panoseti/shuttercontrol/docs/rev2-j/ckt_rev2j.jpeg

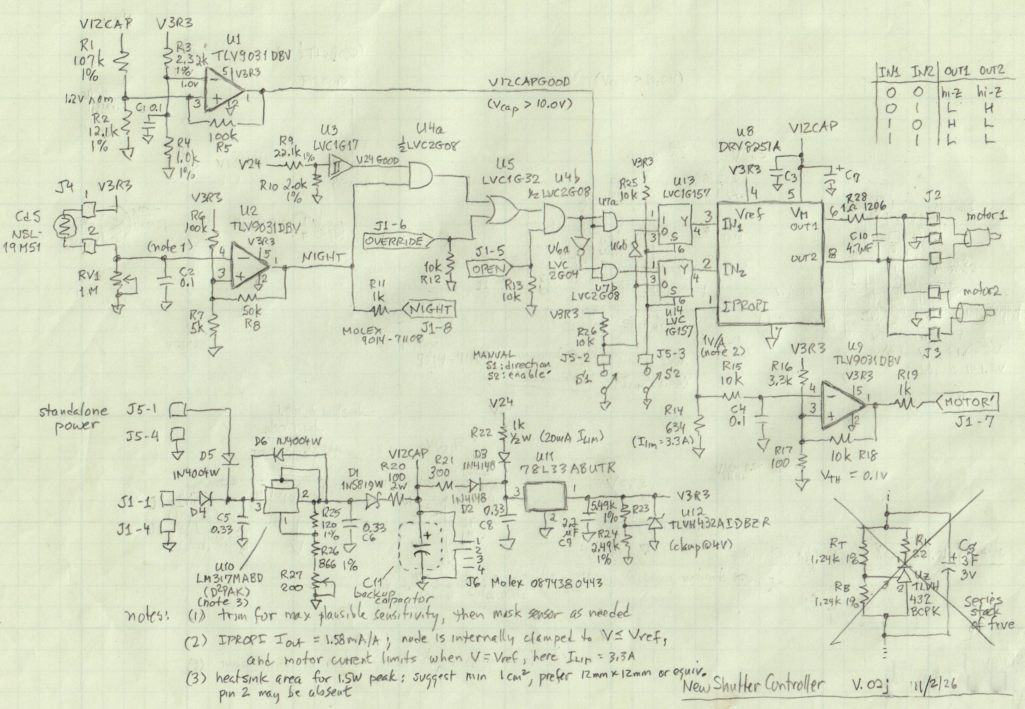
docs/rev2-j/ckt_rev2j.jpeg
