panoseti/shuttercontrol/docs/jlcpcb_capabilities.md

# 嘉立创（JLCPCB）工艺能力与本板设计规则

来源：<https://jlcpcb.com/capabilities/Capabilities>（Rigid PCB，标准工艺），2026-11-02 查阅。
本板：4 层，1.6 mm，外层 1 oz、内层 0.5 oz（嘉立创多层板默认），无铅喷锡，绿色阻焊。

## 叠层

| 层 | 用途 |
|---|---|
| F.Cu | 器件、信号 |
| In1.Cu | GND 整层铺铜（区域名 GND_PLANE） |
| In2.Cu | V3R3 整层铺铜（区域名 V3R3_PLANE） |
| B.Cu | 器件、信号 |

嘉立创 4 层 1.6 mm 标准叠层为 JLC04161H-7628：7628 半固化片约 0.21 mm，芯板约 1.065 mm。KiCad 中的介质厚度目前按平均值 0.48 mm 填写。本板不做阻抗控制，DRC 不受影响，下单时选择标准叠层即可。

## 工艺能力与设定值

| 项目 | 嘉立创能力（多层板，1 oz） | 本板设定 | 写在哪里 |
|---|---|---|---|
| 最小线宽 / 线距 | 0.09 / 0.09 mm（1、2 层板为 0.10 / 0.10 mm） | 最小 0.1 / 0.1 mm；默认网络类线宽 0.2 mm、间距 0.2 mm | `.kicad_pro` |
| 钻孔直径 | 0.15–6.3 mm | 0.15–6.3 mm | `.kicad_dru` |
| 过孔孔径 / 外径 | 最小 0.15 / 0.25 mm；孔径 < 0.2 mm 或外径 < 0.45 mm 加价 | 最小 0.2 / 0.45 mm；默认 0.3 / 0.6 mm | `.kicad_pro`、`.kicad_dru` |
| 孔环 | 插件孔最小 0.15 mm，推荐 0.20 mm；过孔只要求外径 ≥ 孔径 + 0.1 mm | 插件孔 0.15 mm（0.45 / 0.2 mm 过孔的孔环为 0.125 mm） | `.kicad_dru` |
| 孔到孔 | 过孔 0.2 mm；焊盘孔 0.45 mm | 0.2 mm；焊盘之间 0.45 mm | `.kicad_pro`、`.kicad_dru` |
| 孔壁到铜 | 过孔 0.2 mm；插件孔 0.28 mm（推荐 0.35 mm）；非金属化孔 0.2 mm | 0.2 mm；插件孔 0.28 mm | `.kicad_dru` |
| 内层孔壁到铜 | 过孔 0.2 mm；插件焊盘孔 0.3 mm | 插件孔 0.3 mm | `.kicad_dru` |
| 焊盘到导线 | 0.1 mm | 网络类间距 0.2 mm | `.kicad_pro` |
| 不同网络 SMD 焊盘间距 | 0.15 mm | 0.15 mm | `.kicad_dru` |
| 铜到板边（铣边） | 0.2 mm（V 割 0.4 mm） | 0.3 mm | `.kicad_pro`、`.kicad_dru` |
| 阻焊 | 开窗 1:1；阻焊桥最小 0.10 mm（绿色） | 未改，沿用 KiCad 设置 | — |
| 丝印 | 线宽 ≥ 0.15 mm；字高 ≥ 1.0 mm；宽高比 1:6；丝印到焊盘 ≥ 0.15 mm | 位号统一 1.0 mm 字高、0.15 mm 线宽；丝印间距 0.15 mm | `.kicad_dru` |
| 非金属化孔 | 最小 0.5 mm | 安装孔 2.5 mm | — |

其他参考数据：

- 孔径公差 +0.13 / −0.08 mm。
- 外形尺寸公差 ±0.2 mm（普通精度）。
- 板厚可选 0.4 / 0.6 / 0.8 / 1.0 / 1.2 / 1.6 / 2.0 mm。
- 介电常数：7628 半固化片 4.4，3313 为 4.1，2116 为 4.16。
- 内层铜厚默认 0.5 oz，可选 1 oz、2 oz。

## 文件

- `shuttercontrol.kicad_dru`：自定义规则，每条注明来源。
- `shuttercontrol.kicad_pro`：板级最小值、默认网络类，以及常用线宽（0.2 / 0.25 / 0.4 / 0.6 / 1.0 mm）和过孔尺寸（0.6/0.3、0.8/0.4 mm）。
- `docs/shuttercontrol_board_spec.json`：板子外形、安装孔和 4 层叠层。
