panoseti/shuttercontrol/docs/c11_footprint.png

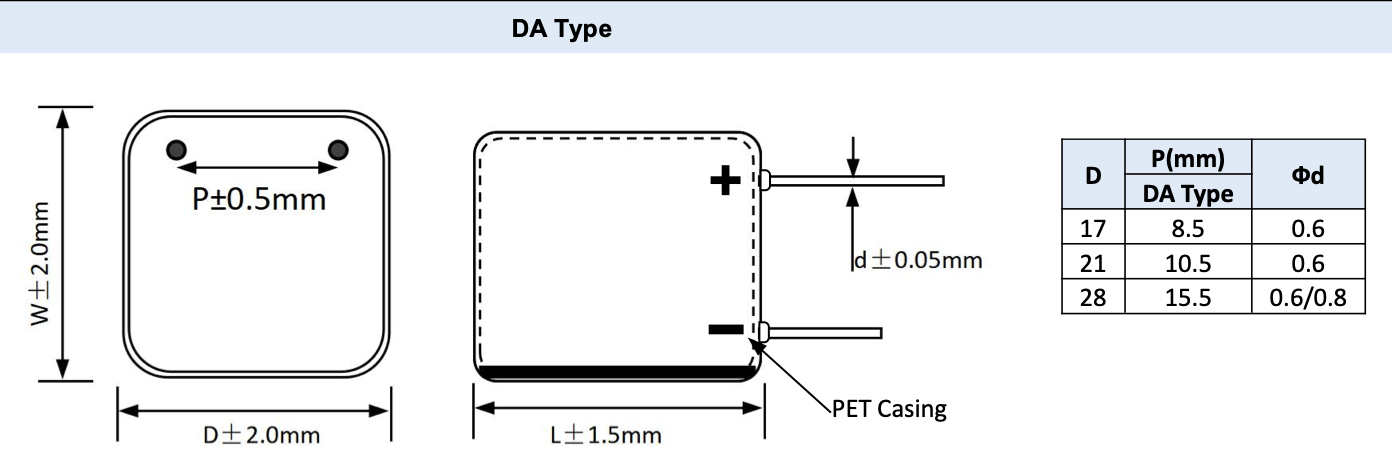
docs/c11_footprint.png
