panoseti/shuttercontrol/docs/rev2-h/ckt_rev2h_p2of2.jpg

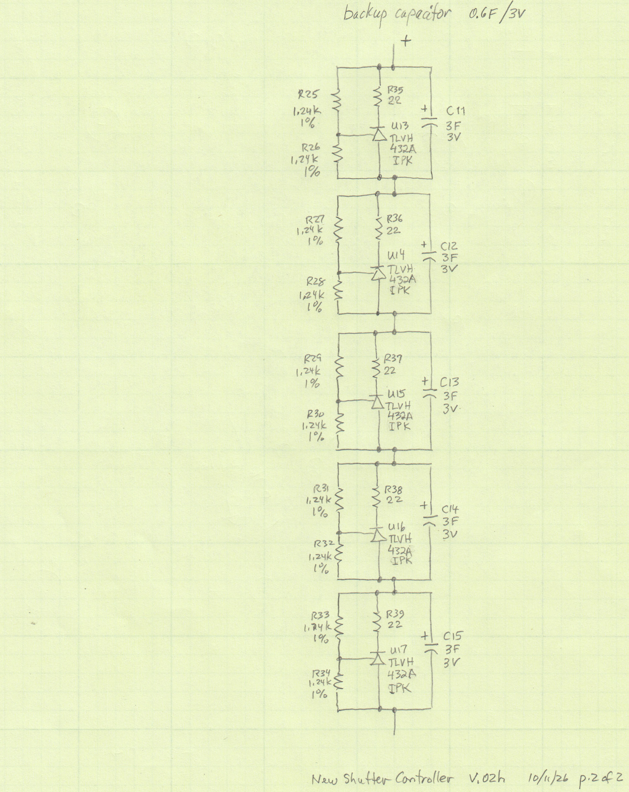
docs/rev2-h/ckt_rev2h_p2of2.jpg
