panoseti/shuttercontrol/outputs/shuttercontrol_3d_bottom.png

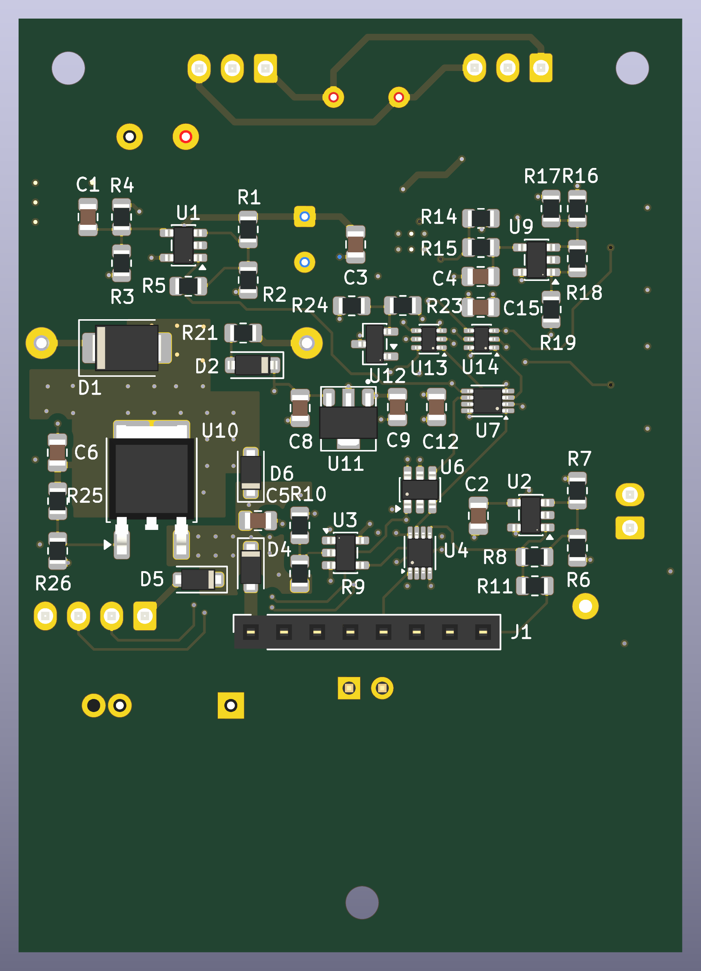
outputs/shuttercontrol_3d_bottom.png
