panoseti/shuttercontrol/outputs/shuttercontrol_3d_iso.png

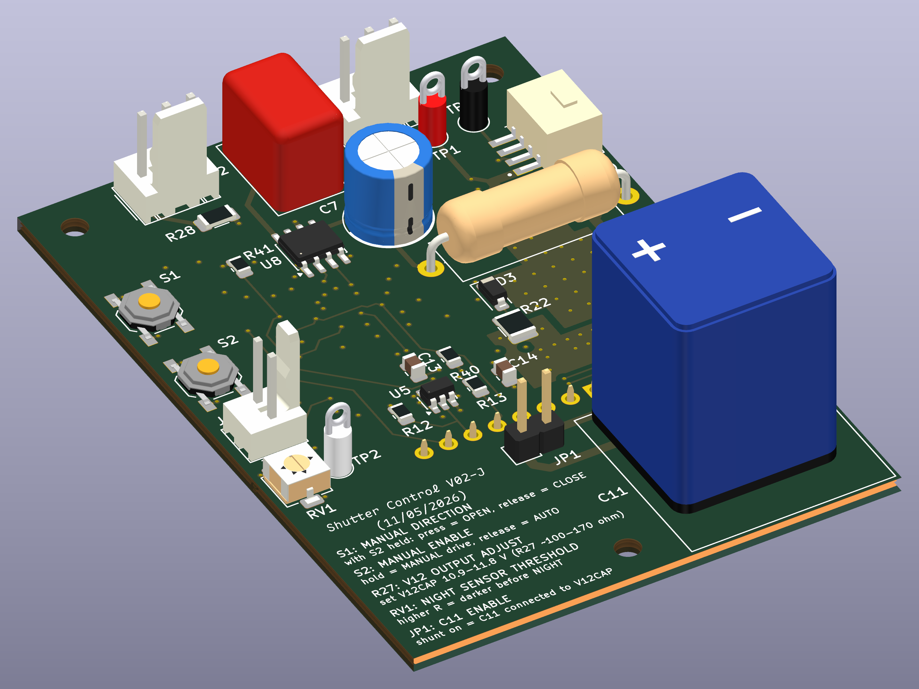
outputs/shuttercontrol_3d_iso.png
