panoseti/shuttercontrol/outputs/shuttercontrol_3d_side.png

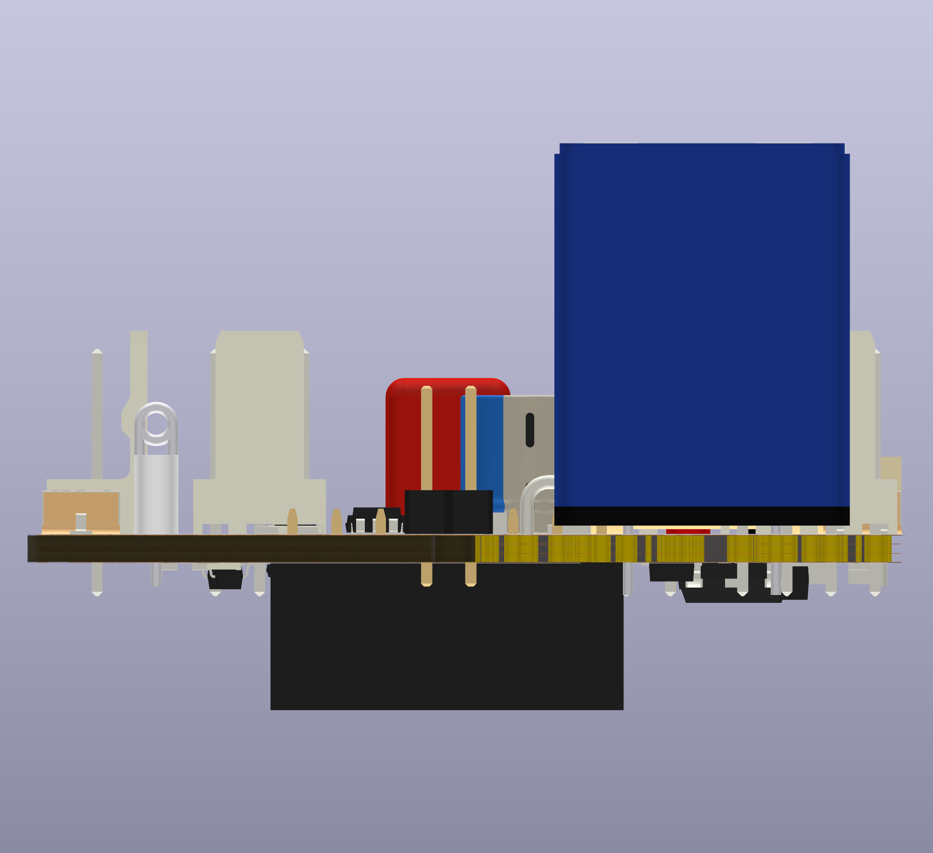
outputs/shuttercontrol_3d_side.png
