panoseti/shuttercontrol/outputs/shuttercontrol_3d_top.png

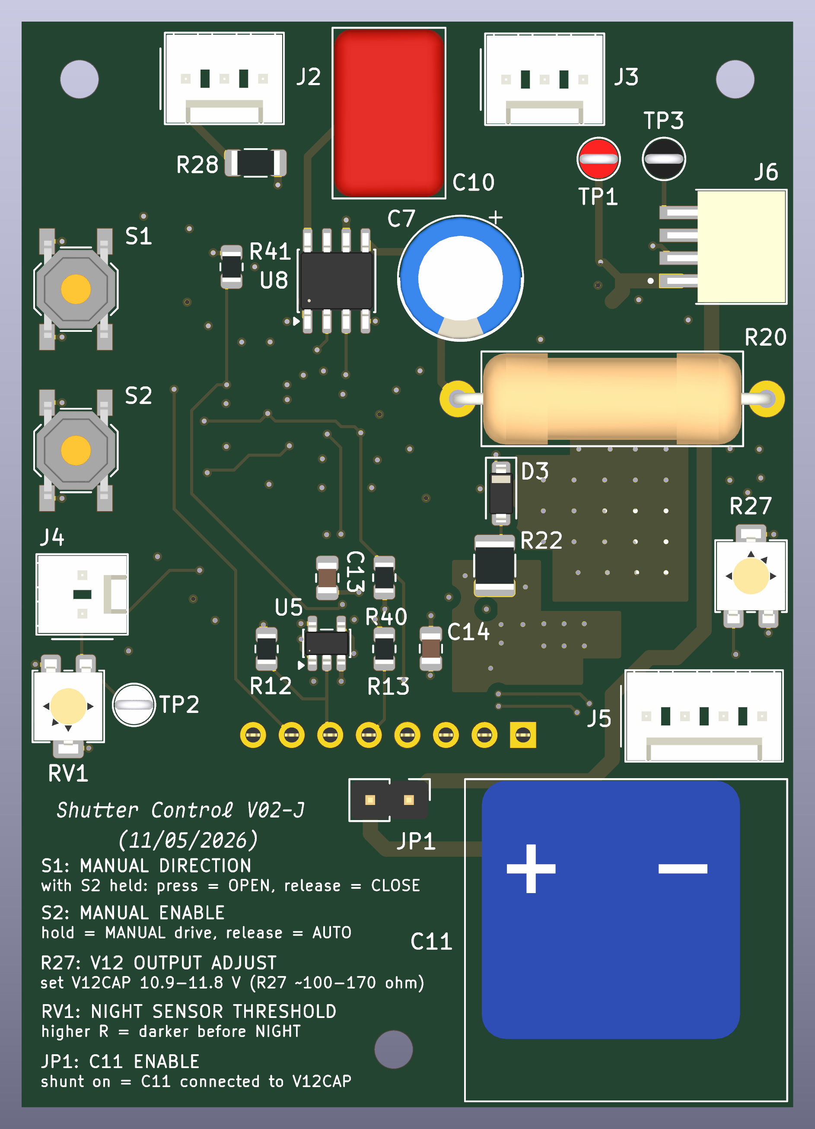
outputs/shuttercontrol_3d_top.png
