panoseti/shuttercontrol/docs/rev2-j/BOM_shutter-controller_2026-11-02.xlsx

Refdes | Description | Value | Manufacturer | Mfg P/N | DigiKey P/N | JLCPCB P/N (*=pre-order) |  | Notes & Substitutions
rev 1.1, 2026-11-02
C1-C4 | capacitor, MLCC, 0805 | 0.1 uF |  |  |  | C49678
C5, C6, C8 | capacitor, MLCC, 0805 | 0.33 uF |  |  |  | C13967
C7 | capacitor, radial, electrolytic, thru-hole | 47 uF, 50V or 63V | Nichicon | UBT1J470MPD8TD | 493-UBT1J470MPD8TDCT-ND |  | DNP
C9 | capacitor, MLCC, 0805 | 2.2 uF |  |  |  | C377773
C10 | capacitor, film, through-hole | 4.7 uF | TDK | B32529D5475M289 | 495-B32529D5475M289CT-ND |  | DNP
C11 | ultracap, through-hole | 0.8F, 12V | Oda | CPM-12R0L804R-TW | 4688-CPM-12R0L804R-TW |  | DNP | optional on-board ultracap
C11 off-board | ultracap, off-board | 1.66F, 16.2V | Tecate | PBLS-1.66/16.2 | 2085-SCAP,PBLS-1.66/16.2-ND |  | N/A | for altenative off-board ultracap
D1 | rectifier, Schottky | 1 A 40V |  | 1N5819W |  | C8165 |  | SMD equiv to 1N5819
D2, D3 | diode | 100 mA 75V |  | 1N4148W |  | C117823 |  | SMD equiv to 1N4148
D4, D5, D6 | rectifier, silicon | 1A 400V |  | 1N4004W |  | C18199087 |  | SMD equiv to 1N4004
J1 | MOBO connector, 8-pin SIP, female |  | Molex | 9014-71108 |  | C6032581 |  | no stock at JLCPCB, we could do as a secondary op with other thru-hole parts
J2, J3 | motor connector, 3-pin | TBD
J4 | photocell connector, 2-pin | TBD
J5 | aux power connector, manual op'n | TBD
J6 | connector to external ultracap | 4-pin through-hole | Molex | 874380443 |  | C564208
R* | resistor, SMD, 0805 | closest E24 value, 5% |  |  |  |  |  | all resistors not specifically listed are 0805 SMD closest E24 value to schematic
R1 | resistor, SMD, 0805 | 107k, 1% |  |  |  | C276295
R2 | resistor, SMD, 0805 | 12.1k, 1%
R3 | resistor, SMD, 0805 | 2.32k, 1%
R4 | resistor, SMD, 0805 | 1.0k, 1%
R9 | resistor, SMD, 0805 | 22.1k, 1%
R10 | resistor, SMD, 0805 | 2.0k, 1%
R14 | resistor, SMD, 0805 | 634 ohms, 1%
R20 | resistor | 100 ohms, 10%, 2W
R22 | resistor | 1k, 5%, 0.5W
R23 | resistor, SMD, 0805 | 5.49k, 1%
R24 | resistor, SMD, 0805 | 2.49k, 1%
R25 | resistor, SMD, 0805 | 120 ohms, 1%
R26 | resistor, SMD, 0805 | 866 ohms, 1%
R27 | trimmer | 200 ohms | Bourns | 3314G-1-201E |  | C52238 |  | SMD 1/4" 1-turn top-adjust
R28 | resistor, SMD, 1206 | 1 ohm |  |  |  | C17928
RV1 | trimmer | 1Mohm | Bourns | 3314G-1-105E |  | C780218 |  | SMD 1/4" 1-turn top-adjust
S1,S2 | pushbutton, SMD, momentary contact
U1, U2, U9 | op-amp | TLV9031DBV | TI | TLV9031DBV |  | C29777121
U3 | logic buffer, Schmitt | 74LVC1G17DBV | TI | 74LVC1G17DBV |  | C7836
U4, U7 | AND gate, dual | 74LVC2G08DCT | TI | 74LVC2G08DCT |  | C456135
U5 | OR gate | 74LVC1G32DBV | TI | 74LVC1G32DBV |  | C10096
U6 | inverter, dual | 74LVC2G04DBV | TI | 74LVC2G04DBV |  | C10428
U8 | H-bridge motor driver | DRV8251ADDAR | TI | DRV8251ADDAR |  | C5218844
U10 | adjustable linear regulator | LM317MABD | TI | LM317MABD |  | C427699
U11 | 3.3V linear regulator | L78L33ABUTR | STM | L78L33ABUTR |  | C81362
U12 | 1.2vV shunt regulator | TLVH432AIDBZR | TI | TLVH432AIDBZR |  | C2157628
- | DIP-10 carrier for U16 and U20 | pitch 100 mils, width 600 mils | Artekit Labs | DA-SOT223-6-P127 | 4695-DA-SOT223-6-P127 | 3.16
