panoseti/shuttercontrol/outputs/shuttercontrol_schematic_pcb.pdf

# 51k GND

# Backup Capacitor (C11, J6)

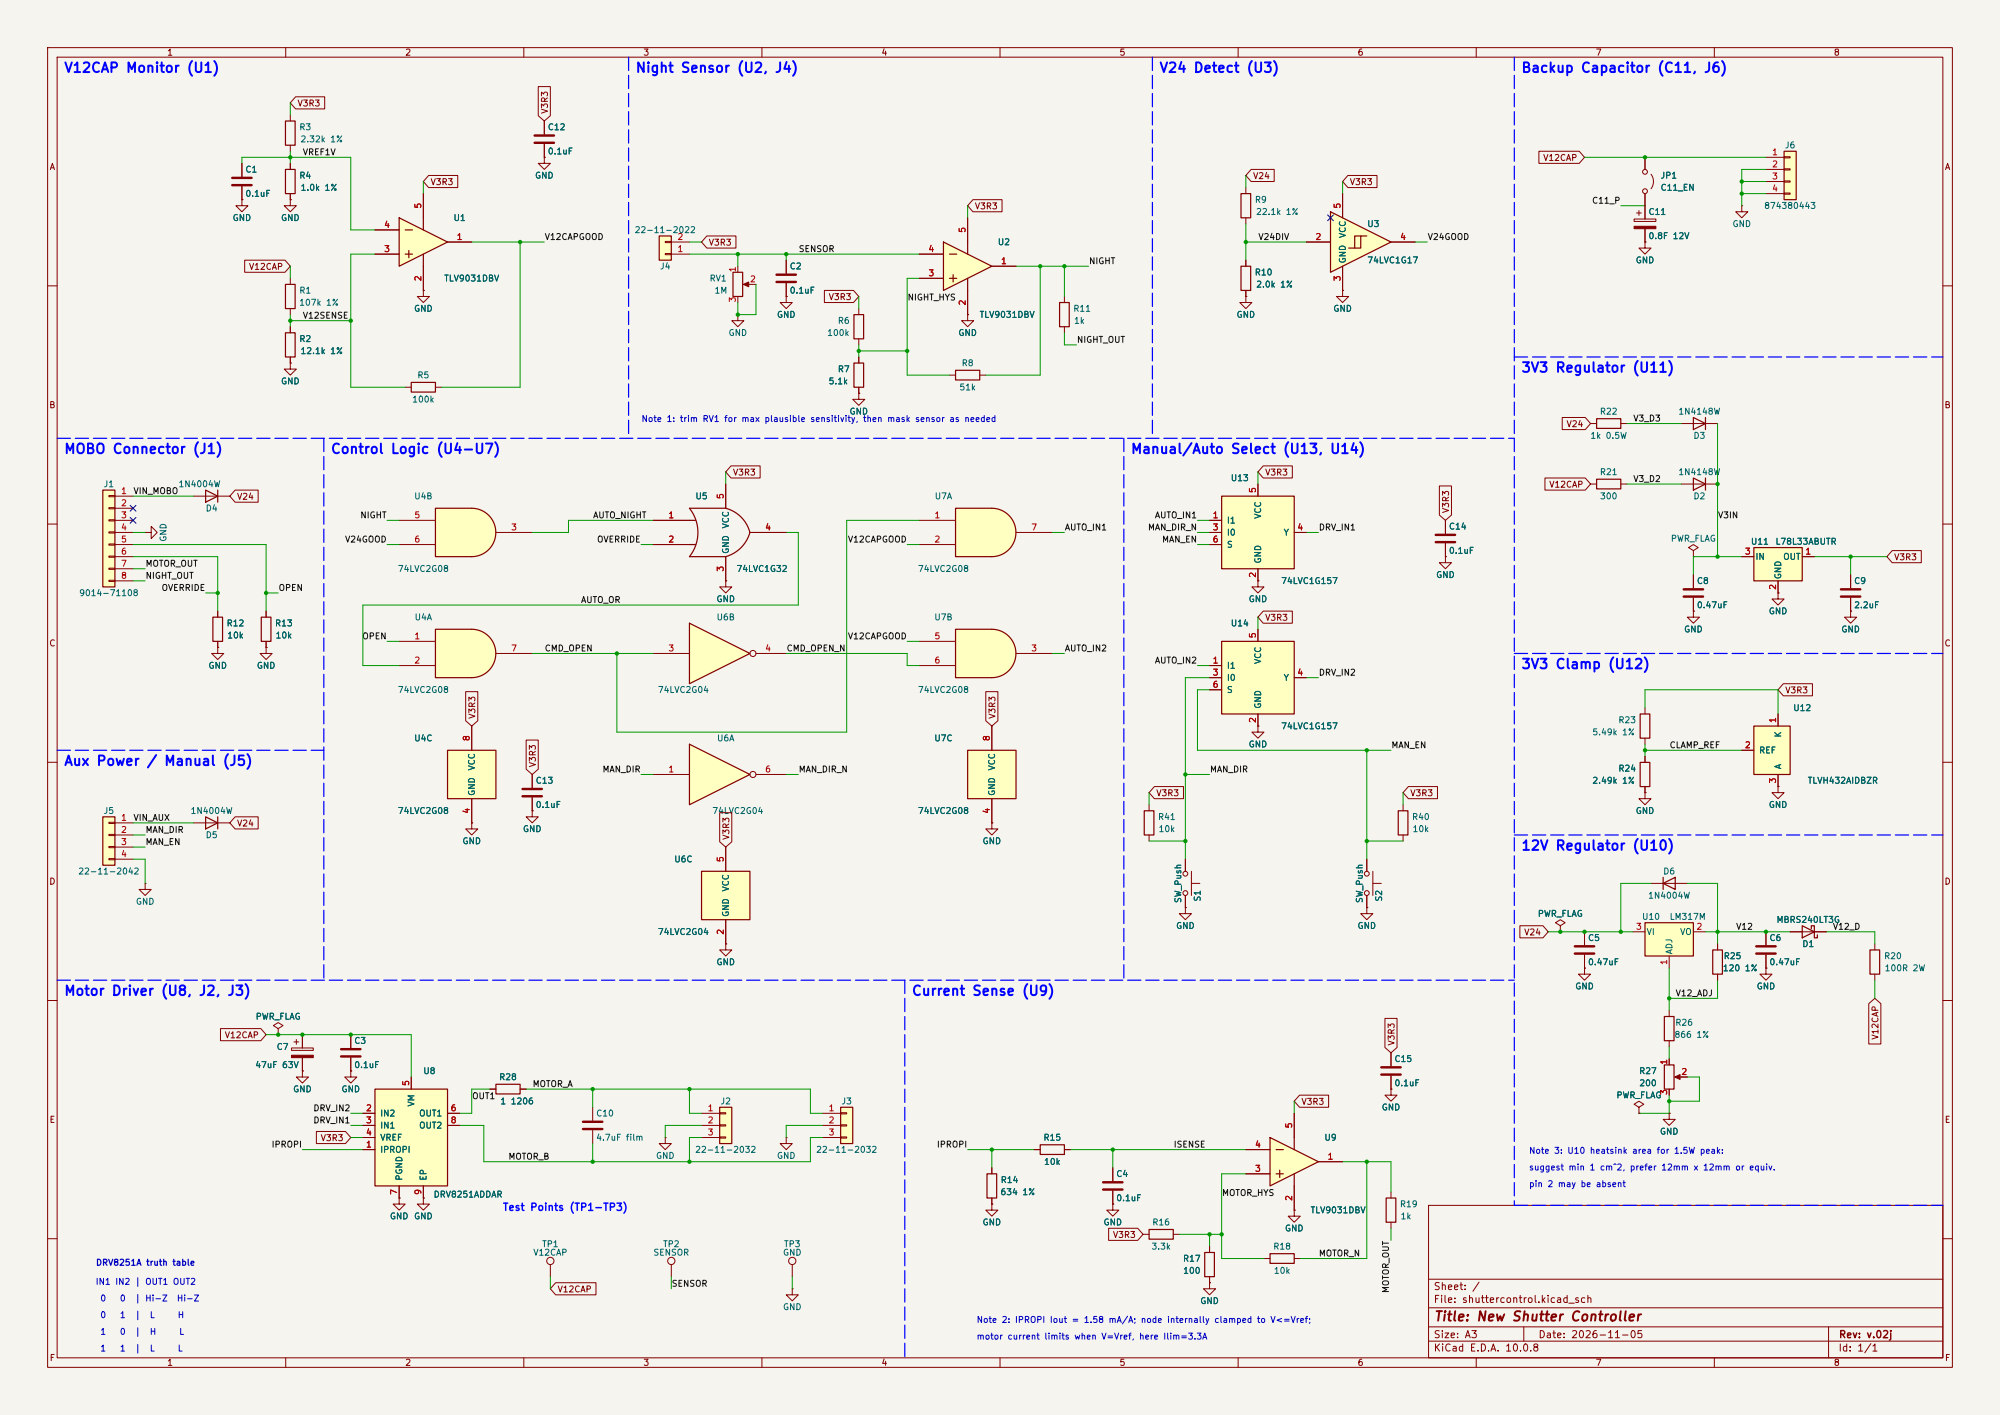
[picture p9: page 1]

Note 1: trim RV1 for max plausible sensitivity, then mask sensor as needed

pin 2 may be absent MOBO Connector (J1)

DRV8251A truth table Motor Driver (U8, J2, J3)

suggest min 1 cm^2, prefer 12mm x 12mm or equiv. Note 3: U10 heatsink area for 1.5W peak:

Sheet: /
File: shuttercontrol.kicad_sch
Title: New Shutter Controller
KiCad E.D.A. 10.0.8

TP1

TP3

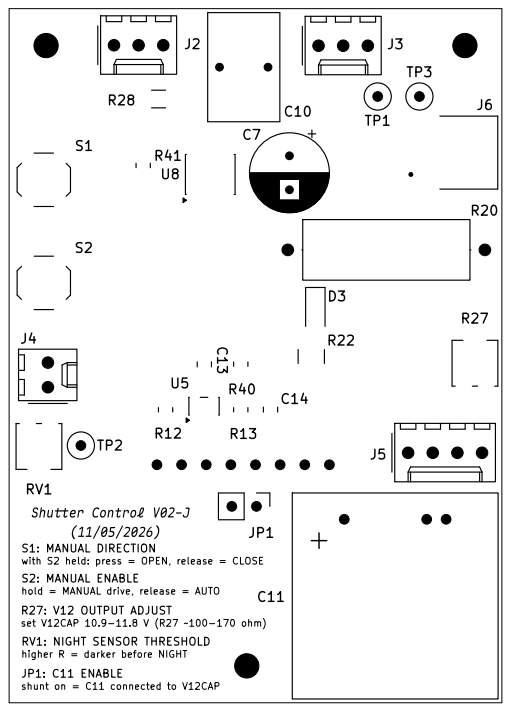
[picture p10: page 2]

S1: MANUAL DIRECTION
with S2 held: press = OPEN, release = CLOSE
S2: MANUAL ENABLE
hold = MANUAL drive, release = AUTO
R27: V12 OUTPUT ADJUST
set V12CAP 10.9-11.8 V (R27 ~100-170 ohm)
RV1: NIGHT SENSOR THRESHOLD
higher R = darker before NIGHT
JP1: C11 ENABLE
shunt on = C11 connected to V12CAP

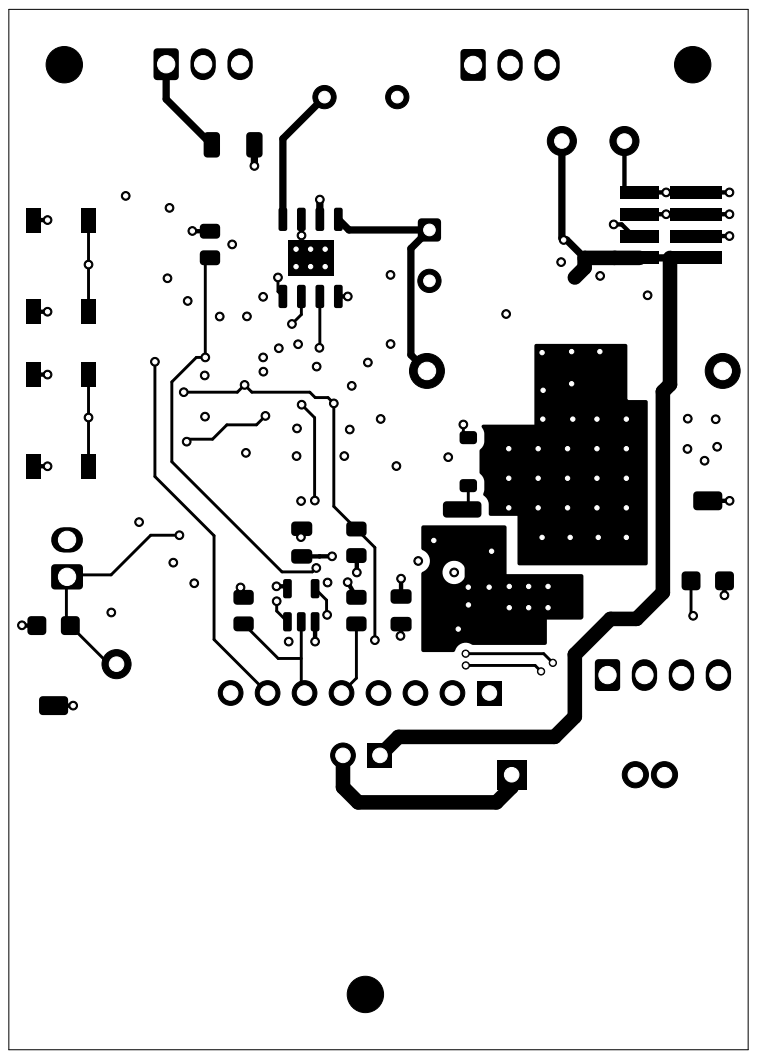
[picture p11: page 3]

H2

# MountingHole_2.5mm

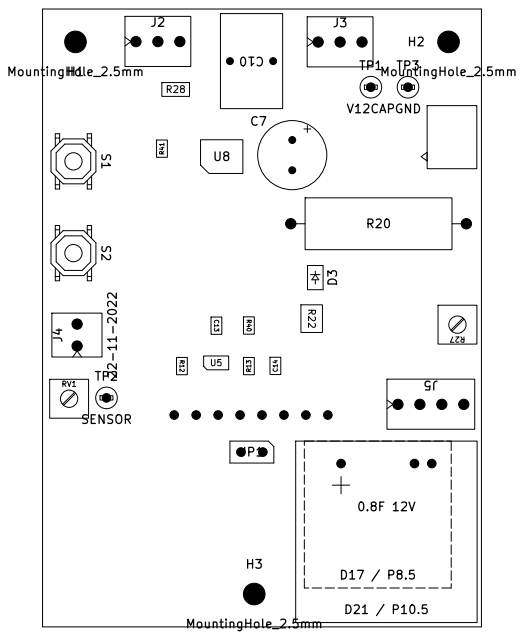
[picture p12: page 4]

R17
R4

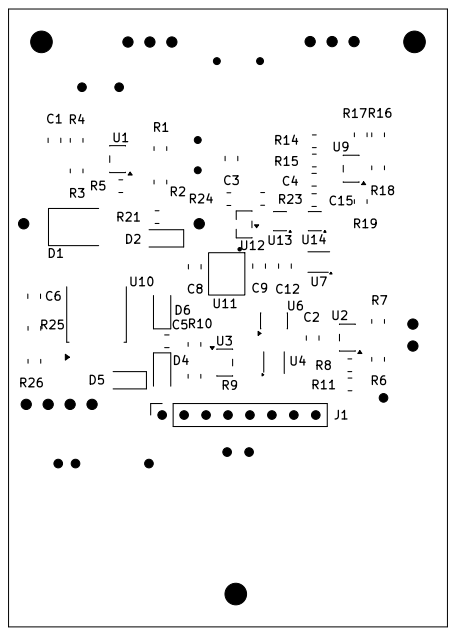
[picture p13: page 5]

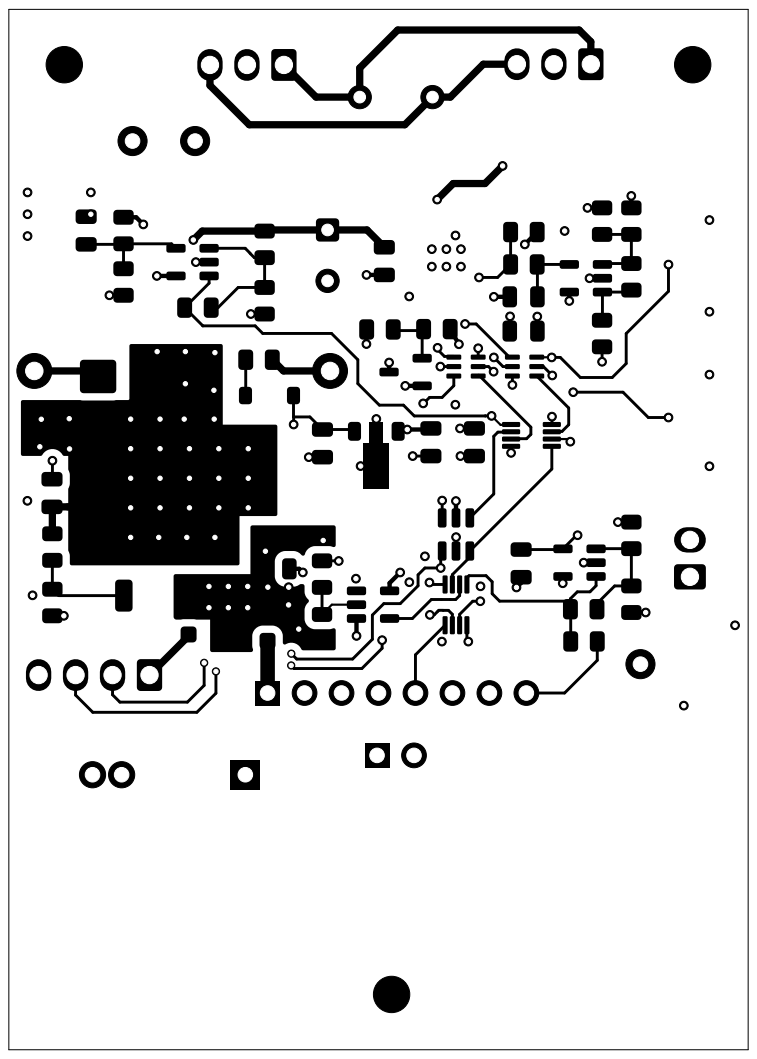
[picture p14: page 6]

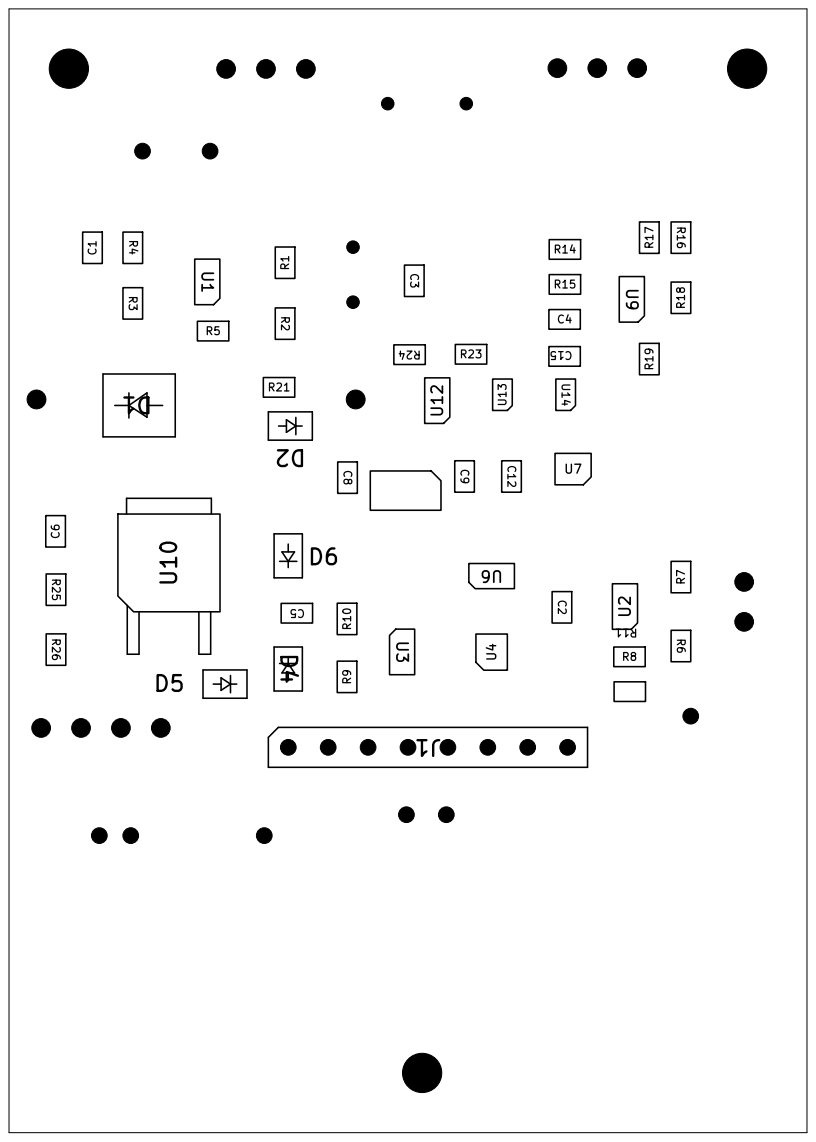
[picture p15: page 7]
