panoseti/shuttercontrol/shuttercontrol.kicad_pcb

## KiCad design shuttercontrol.kicad_pcb (2026-11-09)

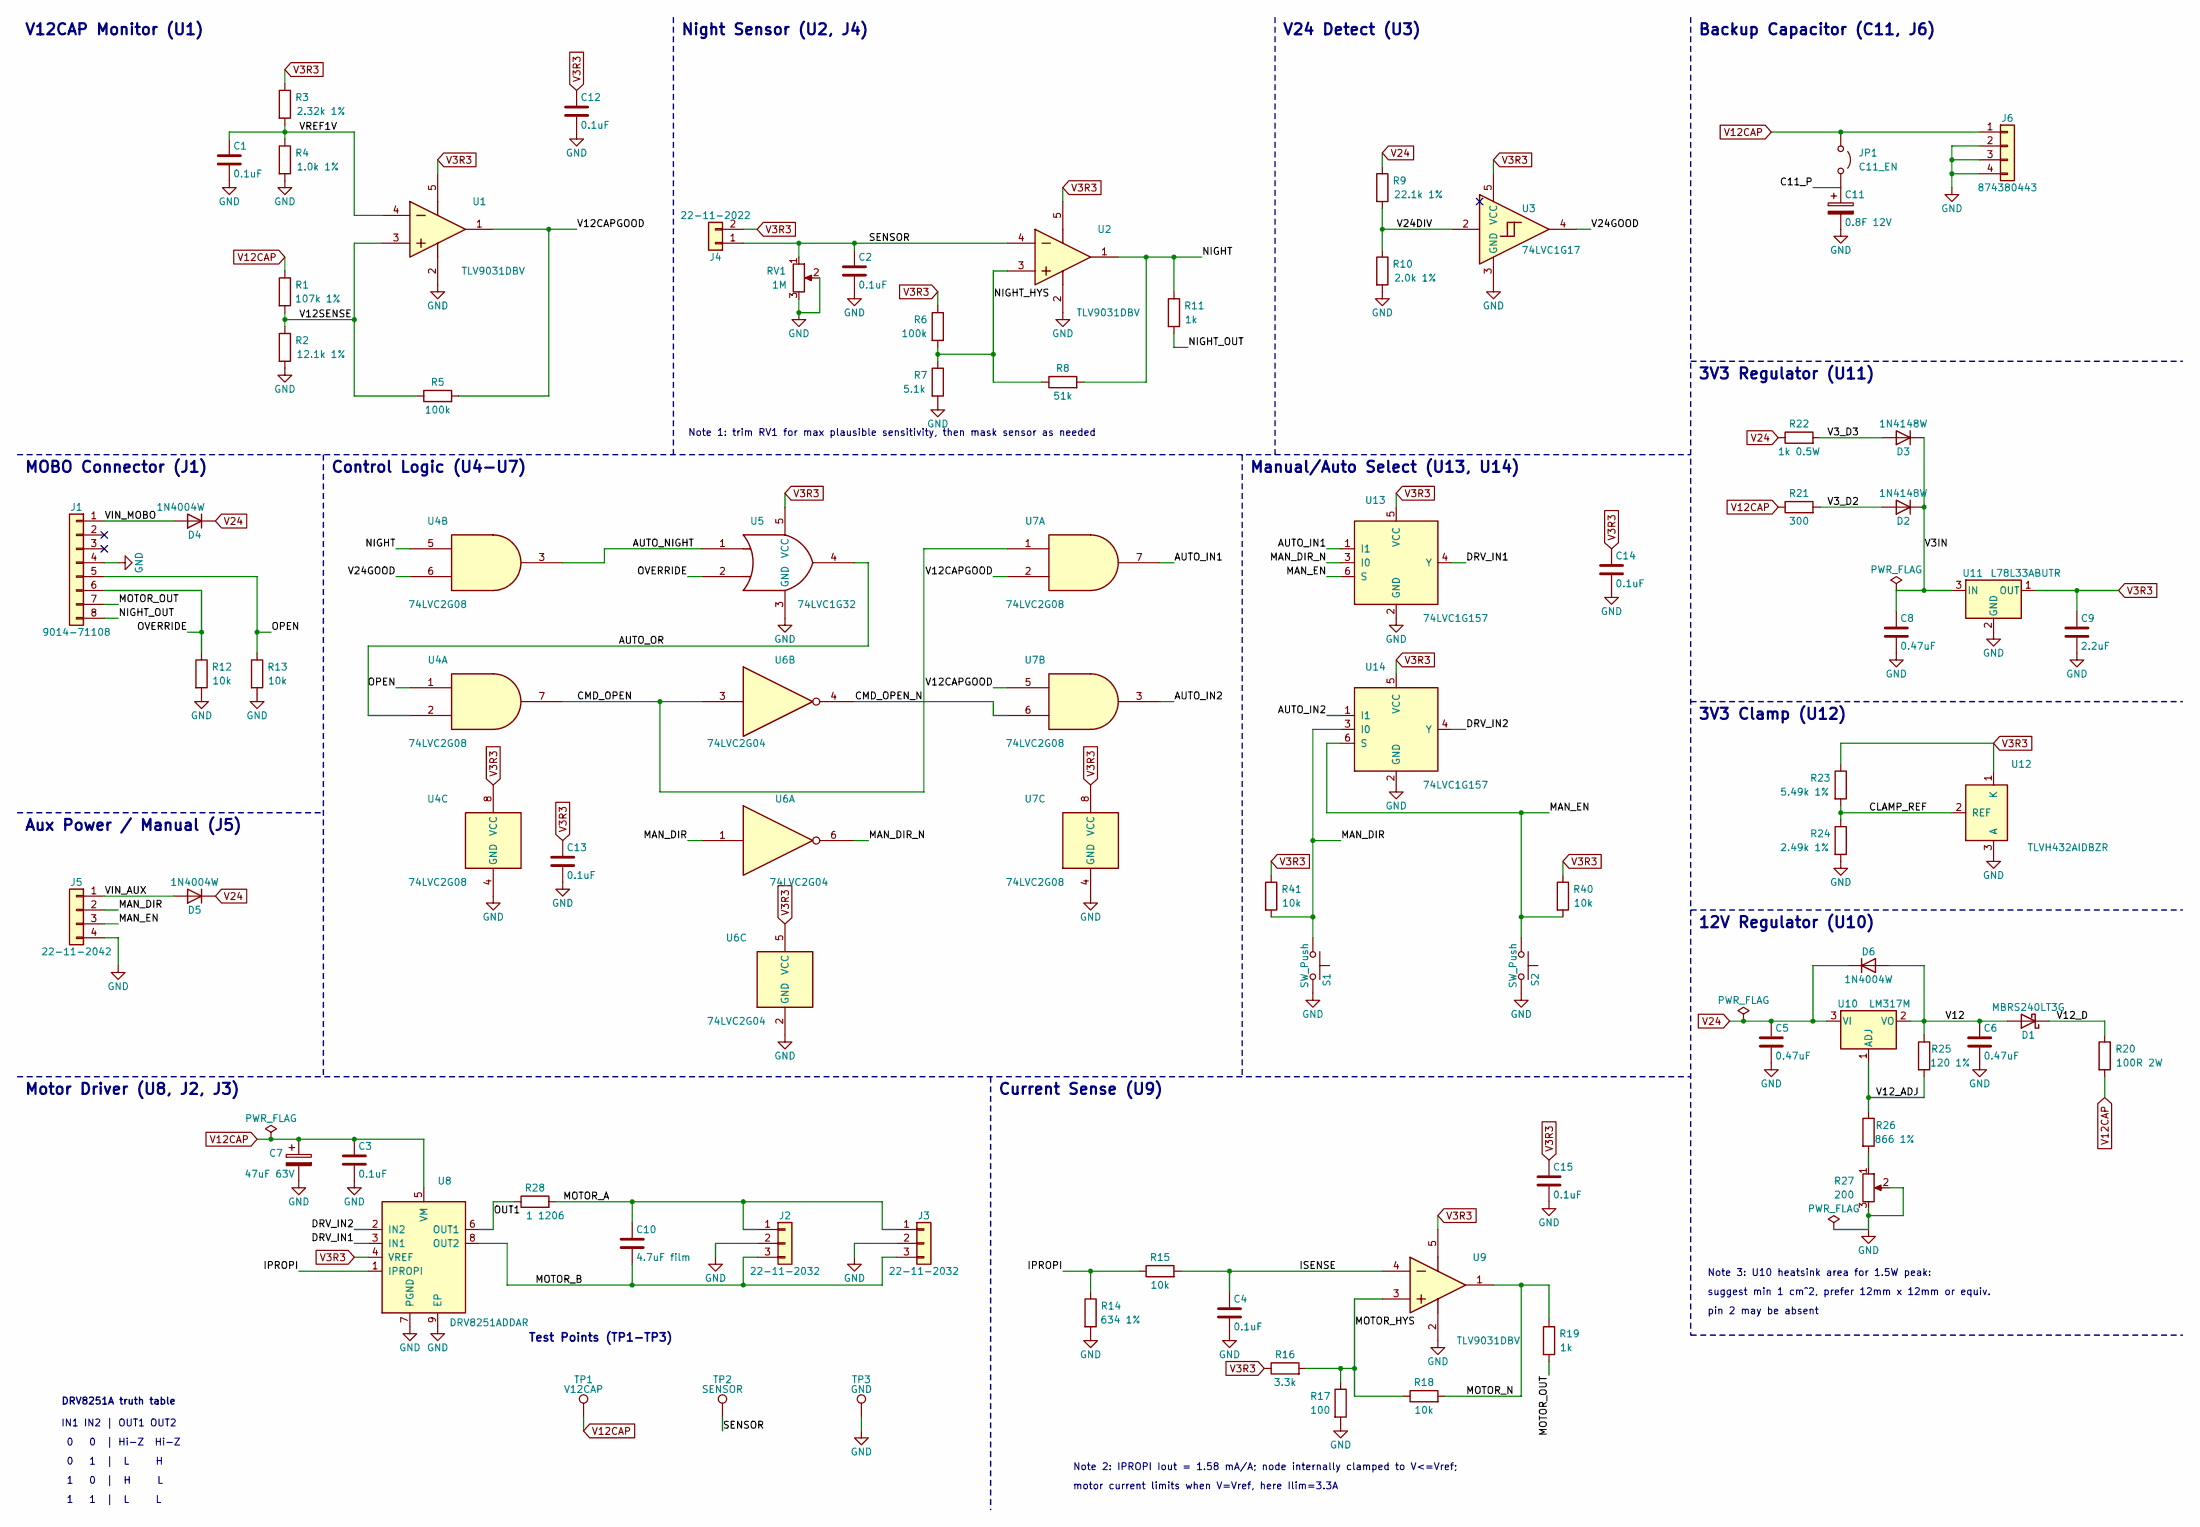
[picture p16: schematic shuttercontrol.kicad_sch, New Shutter Controller]

Parts:
C1, C2, C3, C4, C12, C13, C14, C15: 0.1uF; C_0805_2012Metric; LCSC C49678
C5, C6, C8: 0.47uF; C_0805_2012Metric; LCSC C13967
C7: 47uF 63V; CP_Radial_D8.0mm_P3.50mm; MPN UBT1J470MPD8TD
C9: 2.2uF; C_0805_2012Metric; LCSC C377773
C10: 4.7uF film; C_Rect_L7.2mm_W11.0mm_P5.00mm_FKS2_FKP2_MKS2_MKP2; MPN B32529D5475M289
C11: 0.8F 12V; CDA_CPM_DA_D17.0-21.0mm_P8.50-10.50mm; MPN CPM-12R0L804R-TW
D1: MBRS240LT3G; D_SMB; MPN MBRS240LT3G; LCSC C8165
D2, D3: 1N4148W; D_SOD-123; MPN 1N4148W; LCSC C117823
D4, D5, D6: 1N4004W; D_SOD-123F; MPN 1N4004W; LCSC C18199087
J1: 9014-71108; PinSocket_1x08_P2.54mm_Vertical; MPN 90147-1108; LCSC C6032581
J2, J3: 22-11-2032; Molex_KK-254_AE-6410-03A_1x03_P2.54mm_Vertical; MPN 22112032; LCSC C505163
J4: 22-11-2022; Molex_KK-254_AE-6410-02A_1x02_P2.54mm_Vertical; MPN 22112022; LCSC C505162
J5: 22-11-2042; Molex_KK-254_AE-6410-04A_1x04_P2.54mm_Vertical; MPN 22112042; LCSC C114123
J6: 874380443; Molex_Pico-SPOX_87438-0443_1x04_P1.50mm_Horizontal; MPN 874380443; LCSC C564208
JP1: C11_EN; PinHeader_1x02_P2.54mm_Vertical; MPN PZ254V-11-02P; LCSC C492401
R1: 107k 1%; R_0805_2012Metric; LCSC C276295
R2: 12.1k 1%; R_0805_2012Metric; LCSC C17431
R3: 2.32k 1%; R_0805_2012Metric; LCSC C2933374
R4: 1.0k 1%; R_0805_2012Metric; LCSC C17513
R5, R6: 100k; R_0805_2012Metric; LCSC C149504
R7: 5.1k; R_0805_2012Metric; LCSC C27834
R8: 51k; R_0805_2012Metric; LCSC C17737
R9: 22.1k 1%; R_0805_2012Metric; LCSC C17552
R10: 2.0k 1%; R_0805_2012Metric; LCSC C17604
R11, R19: 1k; R_0805_2012Metric; LCSC C17513
R12, R13, R15, R18, R40, R41: 10k; R_0805_2012Metric; LCSC C17414
R14: 634 1%; R_0805_2012Metric; LCSC C17787
R16: 3.3k; R_0805_2012Metric; LCSC C26010
R17: 100; R_0805_2012Metric; LCSC C17408
R20: 100R 2W; R_Axial_DIN0617_L17.0mm_D6.0mm_P20.32mm_Horizontal; LCSC C58717
R21: 300; R_0805_2012Metric; LCSC C17617
R22: 1k 0.5W; R_1210_3225Metric; LCSC C2930439
R23: 5.49k 1%; R_0805_2012Metric; LCSC C2933466
R24: 2.49k 1%; R_0805_2012Metric; LCSC C21237
R25: 120 1%; R_0805_2012Metric; LCSC C17437
R26: 866 1%; R_0805_2012Metric; LCSC C17849
R27: 200; Potentiometer_Bourns_3314G_Vertical; MPN 3314G-1-201E; LCSC C52238
R28: 1 1206; R_1206_3216Metric; MPN 1206W4F100KT5E; LCSC C17928
RV1: 1M; Potentiometer_Bourns_3314G_Vertical; MPN 3314G-1-105E; LCSC C780218
S1, S2: SW_Push; SW_SPST_TL3342; LCSC C2886897
TP1: V12CAP; TestPoint_Keystone_5000_Red_Miniature; MPN 5000; Digikey 36-5000-ND
TP2: SENSOR; TestPoint_Keystone_5002_White_Miniature; MPN 5002; Digikey 36-5002-ND
TP3: GND; TestPoint_Keystone_5001_Black_Miniature; MPN 5001; Digikey 36-5001-ND
U1, U2, U9: TLV9031DBV; SOT-23-5; MPN TLV9031DBV; LCSC C29777121
U3: 74LVC1G17; SOT-23-5; MPN 74LVC1G17DBV; LCSC C7836
U4, U7: 74LVC2G08; VSSOP-8_2.3x2mm_P0.5mm; MPN 74LVC2G08DCT; LCSC C456135
U5: 74LVC1G32; SOT-23-5; MPN 74LVC1G32DBV; LCSC C10096
U6: 74LVC2G04; SOT-23-6; MPN 74LVC2G04DBV; LCSC C10428
U8: DRV8251ADDAR; HSOP-8-1EP_3.9x4.9mm_P1.27mm_EP2.41x3.1mm; MPN DRV8251ADDAR; LCSC C5218844
U10: LM317M; TO-252-2; MPN LM317MABDTRKG; LCSC C427699
U11: L78L33ABUTR; SOT-89-3_RectPads; MPN L78L33ABUTR; LCSC C81362
U12: TLVH432AIDBZR; SOT-23-3; MPN TLVH432AIDBZR; LCSC C2157628
U13, U14: 74LVC1G157; SOT-363_SC-70-6; MPN 74LVC1G157GW,125; LCSC C135822

Connections:
/AUTO_IN1: U7.7, U13.1 (I1)
/AUTO_IN2: U7.3, U14.1 (I1)
/AUTO_NIGHT: U4.3, U5.1
/AUTO_OR: U4.2, U5.4
/C11_P: C11.1, JP1.2 (B)
/CLAMP_REF: R23.2, R24.1, U12.2 (REF)
/CMD_OPEN: U4.7, U6.3, U7.1
/CMD_OPEN_N: U6.4, U7.6
/DRV_IN1: U8.3 (IN1), U13.4 (Y)
/DRV_IN2: U8.2 (IN2), U14.4 (Y)
/IPROPI: R14.1, R15.1, U8.1 (IPROPI)
/ISENSE: C4.1, R15.2, U9.4 (-IN)
/MAN_DIR: J5.2, R41.2, S1.1, U6.1, U14.3 (I0)
/MAN_DIR_N: U6.6, U13.3 (I0)
/MAN_EN: J5.3, R40.2, S2.1, U13.6 (S), U14.6 (S)
/MOTOR_A: C10.1, J2.1, J3.1, R28.2
/MOTOR_B: C10.2, J2.3, J3.3, U8.8 (OUT2)
/MOTOR_HYS: R16.2, R17.1, R18.1, U9.3 (+IN)
/MOTOR_N: R18.2, R19.1, U9.1 (OUT)
/MOTOR_OUT: J1.7, R19.2
/NIGHT: R8.2, R11.1, U2.1 (OUT), U4.5
/NIGHT_HYS: R6.2, R7.1, R8.1, U2.3 (+IN)
/NIGHT_OUT: J1.8, R11.2
/OPEN: J1.5, R13.1, U4.1
/OUT1: R28.1, U8.6 (OUT1)
/OVERRIDE: J1.6, R12.1, U5.2
/SENSOR: C2.1, J4.1, RV1.1, TP2.1 (1_1), U2.4 (-IN)
/V3IN: C8.1, D2.1 (K), D3.1 (K), U11.3 (IN)
/V3_D2: D2.2 (A), R21.2
/V3_D3: D3.2 (A), R22.2
/V12: C6.1, D1.2 (A), D6.2 (A), R25.1, U10.2 (VO)
/V12CAPGOOD: R5.2, U1.1 (OUT), U7.2, U7.5
/V12SENSE: R1.2, R2.1, R5.1, U1.3 (+IN)
/V12_ADJ: R25.2, R26.1, U10.1 (ADJ)
/V12_D: D1.1 (K), R20.1
/V24DIV: R9.2, R10.1, U3.2
/V24GOOD: U3.4, U4.6
/VIN_AUX: D5.2 (A), J5.1
/VIN_MOBO: D4.2 (A), J1.1
/VREF1V: C1.1, R3.2, R4.1, U1.4 (-IN)
GND: C1.2, C2.2, C3.2, C4.2, C5.2, C6.2, C7.2, C8.2, C9.2, C11.2, C12.2, C13.2, C14.2, C15.2, J1.4, J2.2, J3.2, J5.4, J6.2, J6.3, J6.4, R2.2, R4.2, R7.2, R10.2, R12.2, R13.2, R14.2, R17.2, R24.2, R27.2, R27.3, RV1.2, RV1.3, S1.2, S2.2, TP3.1 (1_1), U1.2 (V-), U2.2 (V-), U3.3 (GND), U4.4 (GND), U5.3 (GND), U6.2 (GND), U7.4 (GND), U8.7 (PGND), U8.9 (EP), U9.2 (V-), U11.2 (GND), U12.3 (A), U13.2 (GND), U14.2 (GND)
unnamed: R26.2, R27.1
V3R3: C9.1, C12.1, C13.1, C14.1, C15.1, J4.2, R3.1, R6.1, R16.1, R23.1, R40.1, R41.1, U1.5 (V+), U2.5 (V+), U3.5 (VCC), U4.8 (VCC), U5.5 (VCC), U6.5 (VCC), U7.8 (VCC), U8.4 (VREF), U9.5 (V+), U11.1 (OUT), U12.1 (K), U13.5 (VCC), U14.5 (VCC)
V12CAP: C3.1, C7.1, J6.1, JP1.1 (A), R1.1, R20.2, R21.1, TP1.1 (1_1), U8.5 (VM)
V24: C5.1, D4.1 (K), D5.1 (K), D6.1 (K), R9.1, R22.1, U10.3 (VI)

Notes on the sheet:
DRV8251A truth table
3V3 Regulator (U11)
Manual/Auto Select (U13, U14)
Note 2: IPROPI Iout = 1.58 mA/A; node internally clamped to V<=Vref;
Test Points (TP1-TP3)
V12CAP Monitor (U1)
Note 1: trim RV1 for max plausible sensitivity, then mask sensor as needed
Current Sense (U9)
1 0 | H L
pin 2 may be absent
motor current limits when V=Vref, here Ilim=3.3A
Motor Driver (U8, J2, J3)
Backup Capacitor (C11, J6)
0 0 | Hi-Z Hi-Z
3V3 Clamp (U12)
Control Logic (U4-U7)
Note 3: U10 heatsink area for 1.5W peak:
12V Regulator (U10)
V24 Detect (U3)
0 1 | L H
1 1 | L L
Aux Power / Manual (J5)
Night Sensor (U2, J4)
suggest min 1 cm^2, prefer 12mm x 12mm or equiv.
MOBO Connector (J1)
IN1 IN2 | OUT1 OUT2

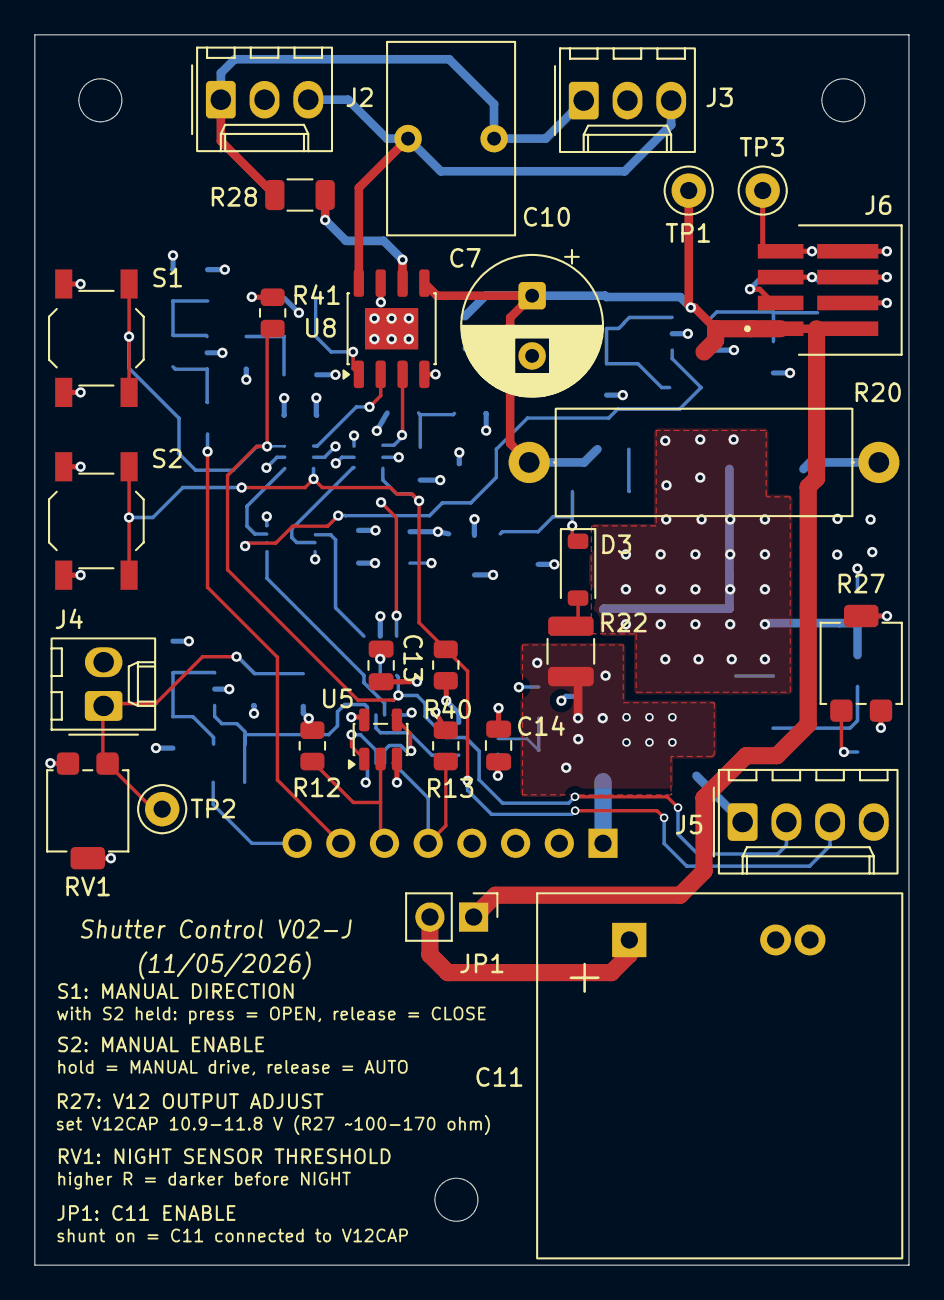
[picture p17: board shuttercontrol.kicad_pcb from above]

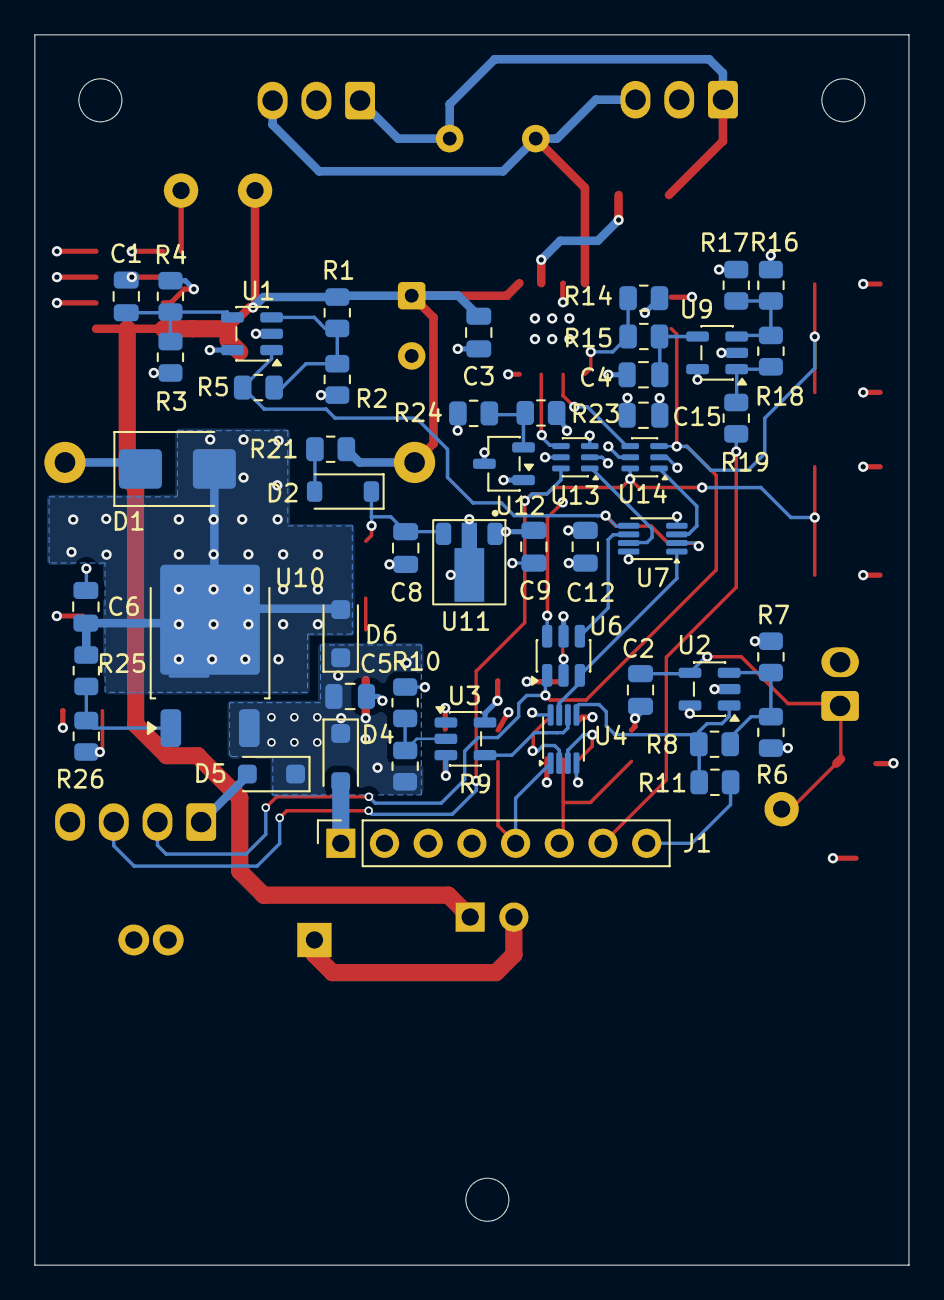
[picture p18: board shuttercontrol.kicad_pcb from below]

Board: 4 copper layers, 50.8 x 71.5 mm, 81 parts (50 on the bottom side), 45 nets.

Other parts of the board:
H1, H2, H3: MountingHole_2.5mm
