panoseti/shuttercontrol/(commit log)

2026-11-01 feat: add shuttercontrol KiCad project from rev V.02h drawings
    - shuttercontrol.kicad_sch: root sheet organised into 13 module regions
    with in-region wiring, JLCPCB TLV9031DBVR comparator symbol
    - backup_cap.kicad_sch: 5 supercap balancing cells in a 2x3 grid
    - shuttercontrol.kicad_sym, sym-lib-table: project symbol library
    (TLV9031DBVR, TLVH432AIPK, DRV8251A, 74LVC1G157)
    - shuttercontrol.kicad_pro/.kicad_pcb/.net: project, empty board, netlist
    - docs: source drawings and BOM, netlist spec, renders, open questions
    - .gitignore: KiCad locks, local history, backups, user settings
    [BOM_shutter-controller.xlsx, backup_cap.kicad_sch, shuttercontrol.kicad_pcb, shuttercontrol.kicad_sch]
2026-11-01 feat: assign JLCPCB part numbers and add JLCPCB BOM export
    - shuttercontrol.kicad_sch, backup_cap.kicad_sch: add LCSC part numbers
    for resistors, connectors J2-J5, switches S1/S2 and muxes U18/U19
    - fab/shuttercontrol_bom_jlcpcb.xlsx: BOM in JLCPCB SMT format
    (DNP parts excluded; L1 and RV1 still without part numbers)
    - docs/jlcpcb_bom_example.xlsx: JLCPCB sample BOM used as the template
    - docs/questions.md: add open questions for L1 current rating and
    RV1 1M trimmer availability
    [backup_cap.kicad_sch, jlcpcb_bom_example.xlsx, shuttercontrol.kicad_sch, shuttercontrol_bom_jlcpcb.xlsx]
2026-11-01 docs: add PDF export of the schematic (2 sheets, A3)
2026-11-02 docs: expand L1 inductor question with JLCPCB search results
    - docs/questions.md Q4: replace the inaccurate "all 4.7 mH parts are
    rated <= 200 mA" claim with the actual top candidates (Bourns
    1140-472K-RC, YPRH1508/1209), why none fit a 3.3 A motor current,
    and why the high-current XR parts are likely common-mode chokes
    - add a common-mode choke option and a resolution table per answer
2026-11-02 feat: add board outline and SOT-89 footprint with rectangular pads
    - shuttercontrol.kicad_pcb: 50.8 x 50.8 mm outline, two 2.5 mm NPTH
    mounting holes and a 2-layer 1.6 mm stackup from the board-3E2 spec
    - docs/board-3E2_board_spec.json: board spec used for the outline
    - shuttercontrol.pretty/SOT-89-3_RectPads: same land pattern as the
    stock SOT-89-3, tab pad built from two rectangular pads so it can be
    placed over KiCad IPC; registered in a new project fp-lib-table
    - schematics: U11-U17 use the new SOT-89 footprint
    [backup_cap.kicad_sch, shuttercontrol.kicad_pcb, shuttercontrol.kicad_sch]
2026-11-03 feat: place rev2-h parts on PCB and add rev2-j design inputs
    - shuttercontrol.kicad_pcb: import all footprints from the schematic,
    place the motor driver block, supercapacitors, connectors and U10 on
    top and the small SMD parts on the bottom (draft placement)
    - docs/rev2-h: move the rev2-h hand-drawn schematics and BOM rev 1.0
    - docs/rev2-j: add the rev2-j schematic (V.02j) and BOM rev 1.1
    - docs/questions.md: split questions into rev2-h (Q1-Q5, answered by
    rev2-j) and rev2-j (Q6-Q15), add the rev2-j change summary, JLCPCB
    part selections and the designer's answers
    - remove outdated schematic renders from docs
    [BOM_shutter-controller.xlsx, BOM_shutter-controller_2026-11-02.xlsx, shuttercontrol.kicad_pcb]
2026-11-03 feat: update schematic to rev2-j and add Pico-SPOX footprint
    - shuttercontrol.kicad_sch: replace LM7812 with LM317M (R25-R27, D6),
    replace the 5-cell balanced supercap sheet with C11 and connector J6,
    replace L1 with R28 (1 ohm 1206), U12 to TLVH432AIDBZR (SOT-23),
    rename U18/U19 to U13/U14 (Nexperia SOT-363), D1 to MBRS240LT3G (SMB),
    RV1 to 3314G, update LCSC/MPN fields, redraw module regions and keep
    all symbols and labels inside the frame
    - backup_cap.kicad_sch: remove the obsolete backup capacitor sheet
    - shuttercontrol.kicad_sym: add TLVH432AIDBZR symbol (1 K, 2 REF, 3 A)
    - shuttercontrol.pretty: add Molex 87438-0443 Pico-SPOX R/A SMT footprint
    per the Molex drawing, with a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
    [backup_cap.kicad_sch, shuttercontrol.kicad_sch]
2026-11-03 feat: sync PCB to rev2-j schematic and add 3D models
    - shuttercontrol.kicad_pcb: remove obsolete footprints (balancing cells,
    C12-C15, L1) and footprints whose package changed, re-import from the
    rev2-j schematic (LM317 DPAK, D1 SMB, D6, R25-R28, RV1/R27 3314G,
    U12 SOT-23, U13/U14 SOT-363, C11 wire pads, J6 Pico-SPOX)
    - place the new parts provisionally, keeping the previous positions of
    unchanged parts; no new DRC errors
    - assign library 3D models to every footprint except H1, H2 and C11,
    and the project VRML model to J6
    [shuttercontrol.kicad_pcb]
2026-11-03 feat: convert board to 4 layers with JLCPCB rules and clean silkscreen
    - shuttercontrol.kicad_pcb: 4-layer 1.6 mm stackup, In1.Cu GND plane,
    In2.Cu V3R3 plane; spread the dense bottom logic cluster slightly and
    move J6, U11, U12 and the R10/R13/R41 column to make room for
    references; all references 1.0 mm / 0.15 mm, clear of pads, parts
    and the board edge
    - shuttercontrol.kicad_dru: custom rules from JLCPCB multilayer
    capabilities (hole sizes, PTH annular ring, hole-to-copper, SMD
    pad-to-pad 0.15 mm, edge clearance, silkscreen text and clearance)
    - shuttercontrol.kicad_pro: board minimums (0.1 mm track/clearance,
    0.45/0.2 mm via, 0.2 mm hole-to-hole, 0.3 mm edge) and predefined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
    [shuttercontrol.kicad_pcb]
2026-11-03 feat: re-lay out PCB per rev2-j and add 3V3 bypass capacitors
    - shuttercontrol.kicad_sch: add C12-C15 (0.1uF 0805, C49678) on V3R3/GND,
    spread across the logic devices per designer note
    - shuttercontrol.kicad_pcb: new floorplan (LM317 block with heatsink area,
    R20/J6/C11 at left edge, logic on bottom with bypass caps near each IC,
    motor driver unchanged); small part shifts to make room for references;
    all reference designators horizontal, 1.0 mm text, no silkscreen
    overlaps or parts covering text; H1/H2 references moved to Fab
    [shuttercontrol.kicad_pcb, shuttercontrol.kicad_sch]
2026-11-03 feat: switch J2-J5 to Molex KK-254 and rearrange PCB for routability
    - shuttercontrol.kicad_sch: J2/J3 22-11-2032, J4 22-11-2022, J5 22-11-2042
    with KK-254 footprints, LCSC, MPN, Manufacturer and Digikey fields;
    add note 3 (U10 heatsink area)
    - shuttercontrol.kicad_pcb: ratsnest-driven re-placement (827 -> 656 mm,
    149 -> 71 crossings); KK-254 connectors moved inboard (J3 below C7),
    D2/R22/RV1 nudged for clearance; J1 locked on B.Cu; all reference
    designators re-placed horizontally with no silkscreen violations
    - docs/shuttercontrol_schematic.pdf: re-export of the updated schematic
    [shuttercontrol.kicad_pcb, shuttercontrol.kicad_sch]
2026-11-04 finished the manual placement.
    [shuttercontrol.kicad_pcb, shuttercontrol.kicad_sch]
2026-11-04 feat: add CDA CPM footprint and 3D model for C11 supercapacitor
    - shuttercontrol.pretty: new CDA_CPM_DA_W17.0mm_D17.0mm_L22.0mm_P8.50mm
    footprint (DA type, 8.5 mm pitch, 0.6 mm leads) for CPM-12R0L804R-TW
    - shuttercontrol.3dshapes: new C11 VRML model; regenerate J6 Pico-SPOX
    model with outward-facing faces and cavity, pins and latch detail
    - shuttercontrol.kicad_sch: C11 footprint, manufacturer and description
    - shuttercontrol.kicad_pcb: C11 swapped to the new footprint
    - docs/c11_footprint.png: CPM DA-type dimension drawing
    [shuttercontrol.kicad_pcb, shuttercontrol.kicad_sch]
2026-11-04 fix: restore 50.8 mm board outline and add J2-J5 3D models
    - shuttercontrol.kicad_pcb: reset Edge.Cuts outline to 50.8 x 50.8 mm
    (right edge had drifted to 151.32)
    - add KiCad KK-254 vertical STEP models to J2-J5
    - carry over manual placement adjustments and refilled zones
    [shuttercontrol.kicad_pcb]
2026-11-04 fix: move J6 and R20 to clear courtyard overlap
    - shuttercontrol.kicad_pcb: J6 to (145.515, 114.83), R20 to (149.05, 124.85)
    [shuttercontrol.kicad_pcb]
2026-11-04 feat: extend board outline to 50.8 x 71.5 mm to fit C11
    - shuttercontrol.kicad_pcb: Edge.Cuts bottom edge moved from y 150.8 to 171.5
    - add GND_PLANE_EXT (In1.Cu) and V3R3_PLANE_EXT (In2.Cu) zones covering the
    new area; they still overlap the original planes at equal priority
    - C11 placed in the extended area at (135.5, 155.26)
    [shuttercontrol.kicad_pcb]
2026-11-04 feat: route outer-layer signals and fan out GND/V3R3 to inner planes
    - shuttercontrol.kicad_pcb: add Freerouting top/bottom signal routing,
    71 GND/V3R3 fanout vias with pad stubs (incl. U8 exposed-pad thermal
    vias) and refilled In1 GND / In2 V3R3 planes
    - shuttercontrol.kicad_pro: change default zone pad connection setting
    [shuttercontrol.kicad_pcb]
2026-11-04 fix: merge inner plane zones and complete V12/V12_ADJ/GND connections
    - shuttercontrol.kicad_pcb: remove GND_PLANE_EXT and V3R3_PLANE_EXT and
    extend GND_PLANE (In1) / V3R3_PLANE (In2) over the full outline
    - shuttercontrol.kicad_pcb: add B.Cu tracks for C6 GND, V12 via and
    U10-R26 V12_ADJ connections
    [shuttercontrol.kicad_pcb]
2026-11-04 docs: add board title and control usage notes to top silkscreen
    - shuttercontrol.kicad_pcb: add "Shutter Control V02-J" title and
    silkscreen notes for S1 (manual direction), S2 (manual enable),
    RV1 (night sensor threshold) and R27 (V12 output adjust)
    [shuttercontrol.kicad_pcb]
2026-11-04 docs: add schematic/PCB PDFs, 3D renders and detailed BOM outputs
    - docs/outputs: schematic PDF, PCB PDF (top and mirrored bottom silk,
    copper and fab layers, no inner planes) and combined PDF
    - docs/outputs: 3D renders of top, bottom, side and isometric views
    - docs/outputs: detailed BOM (xlsx/csv) with manufacturer, MPN, LCSC
    and DigiKey part numbers, plus JLCPCB assembly BOM
    [shuttercontrol_bom.csv, shuttercontrol_bom.xlsx, shuttercontrol_bom_jlcpcb.csv]
2026-11-06 feat: add V12CAP, SENSOR and GND test points (TP1-TP3)
    - Schematic: add Keystone 5000/5002/5001 test points on V12CAP, SENSOR and GND with Digikey/MPN fields
    - PCB: place TP1/TP3 near J3/J6 and TP2 next to RV1, route to nets and refill zones
    - Footprints: add red/white/black Keystone miniature test point footprints to project library
    - 3D models: add simplified colored VRML models for Keystone 5000/5001/5002
    [shuttercontrol.kicad_pcb, shuttercontrol.kicad_sch]
2026-11-06 feat: make C11 footprint fit both 17 mm and 21 mm CPM supercaps
    - shuttercontrol.pretty: replace CDA_CPM_DA_W17.0mm_D17.0mm_L22.0mm_P8.50mm with
    CDA_CPM_DA_D17.0-21.0mm_P8.50-10.50mm (shared + pad, - pads at 8.5 and 10.5 mm,
    21 x 21 mm silkscreen outline, both body outlines on F.Fab)
    - shuttercontrol.kicad_pcb: move C11 to (134.55, 152.6), reroute V12CAP to the new
    + pad, narrow and shift title silkscreen to clear the 21 mm outline, refill zones
    - shuttercontrol.kicad_sch: update C11 footprint and note CPM-12R0L255R-TW
    (2.5 F, 21 x 21 x 32 mm) compatibility in the description
    [shuttercontrol.kicad_pcb, shuttercontrol.kicad_sch]
2026-11-06 feat: add JP1 header jumper between C11 and V12CAP
    - shuttercontrol.kicad_sch: insert JP1 (Jumper_2_Open, 1x02 2.54 mm header)
    between V12CAP and C11 +, new C11_P net; move C11 and its GND down
    - shuttercontrol.kicad_pcb: add JP1 PinHeader_1x02_P2.54mm_Vertical with 3D model,
    place and route it, move C11 + pad to C11_P, refill zones
    - shuttercontrol.kicad_pcb: add JP1 usage note to top silkscreen and split the
    board title into name and date lines
    [shuttercontrol.kicad_pcb, shuttercontrol.kicad_sch]
2026-11-06 feat: add H3 mounting hole and JLCPCB fabrication outputs
    - shuttercontrol.kicad_pcb: add H3 M2.5 mounting hole at the bottom edge left of C11
    - shuttercontrol.kicad_sch/.kicad_pro: rearrange J4 photocell connector wiring and labels
    - fab: add Gerbers, Excellon drill files and drill maps, JLCPCB gerber zip,
    assembly BOM and CPL (TP1-TP3, C11 and DNP parts excluded; JP1 as C492401)
    - outputs: move from docs/outputs to repo root and regenerate schematic/PCB PDFs,
    3D renders and detailed BOM with TP1-TP3, JP1 and the dual C11 footprint
    [shuttercontrol-B_Cu.gbl, shuttercontrol-B_Mask.gbs, shuttercontrol-B_Paste.gbp, shuttercontrol-B_Silkscreen.gbo, shuttercontrol-Edge_Cuts.gm1, shuttercontrol-F_Cu.gtl, shuttercontrol-F_Mask.gts, shuttercontrol-F_Paste.gtp]
2026-11-06 feat: assign LCSC C492401 header to JP1
    - shuttercontrol.kicad_sch/.kicad_pcb: add LCSC C492401, MPN PZ254V-11-02P
    and manufacturer XFCN fields to JP1
    - outputs: add JP1 part numbers to the detailed BOM and add JP1 to the
    JLCPCB assembly BOM, matching fab/
    [shuttercontrol.kicad_pcb, shuttercontrol.kicad_sch, shuttercontrol_bom.csv, shuttercontrol_bom.xlsx, shuttercontrol_bom_jlcpcb.csv]
2026-11-06 fix: drop J1 from JLCPCB assembly and merge duplicate C17513 BOM lines
    - fab, outputs: list R4, R11 and R19 on one JLCPCB BOM line (C17513);
    remove out-of-stock J1 (C6032581) from the assembly BOM and CPL
    - shuttercontrol.kicad_sch/.kicad_pcb: add DigiKey WM14834-ND to J1 and
    correct its MPN to 90147-1108
    - outputs: mark J1 as hand-soldered DigiKey part in the detailed BOM
    [shuttercontrol.kicad_pcb, shuttercontrol.kicad_sch, shuttercontrol_bom.csv, shuttercontrol_bom.xlsx, shuttercontrol_bom_jlcpcb.csv, shuttercontrol_bom_jlcpcb.xlsx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]
2026-11-06 fix: restore J1 to the JLCPCB assembly BOM and CPL
    - fab, outputs: list J1 (C6032581) again in the JLCPCB BOM and CPL so it
    can be deselected at order time
    - outputs: update the J1 note in the detailed BOM accordingly
    [shuttercontrol_bom.csv, shuttercontrol_bom.xlsx, shuttercontrol_bom_jlcpcb.csv, shuttercontrol_bom_jlcpcb.xlsx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]
2026-11-06 fix: align JLCPCB CPL with part centers and refresh silkscreen outputs
    - shuttercontrol.kicad_pcb: adjust silkscreen text placement
    - fab/shuttercontrol_cpl_jlcpcb.csv/.xlsx: move J1-J5, JP1 and R20 from
    pin-1 origin to pad center; rotate J6 to 90 deg to match JLCPCB model
    - fab/gerber: regenerate Gerbers and drill files (only silkscreen changed)
    - fab/gerber.zip, fab/shuttercontrol_gerber_jlcpcb.zip: repack Gerber archives
    - outputs: regenerate PCB PDFs and 3D renders
    [shuttercontrol-B_Cu.gbl, shuttercontrol-B_Mask.gbs, shuttercontrol-B_Paste.gbp, shuttercontrol-B_Silkscreen.gbo, shuttercontrol-Edge_Cuts.gm1, shuttercontrol-F_Cu.gtl, shuttercontrol-F_Mask.gts, shuttercontrol-F_Paste.gtp]
2026-11-09 fix: move C7 silkscreen reference and restore Maple Mono title font
    - shuttercontrol.kicad_pcb: move C7 silkscreen reference above the capacitor
    - fab/gerber: regenerate Gerbers and drill files; F.Silkscreen now carries
    the new C7 position and the Maple Mono NF board title glyphs
    - shuttercontrol_rev2_j.zip: add packaged outputs archive
    - .gitignore: ignore macOS .DS_Store files
    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
    [shuttercontrol-B_Cu.gbl, shuttercontrol-B_Mask.gbs, shuttercontrol-B_Paste.gbp, shuttercontrol-B_Silkscreen.gbo, shuttercontrol-Edge_Cuts.gm1, shuttercontrol-F_Cu.gtl, shuttercontrol-F_Mask.gts, shuttercontrol-F_Paste.gtp]
2026-11-09 docs: add TE 534237-6 as J1 alternate and remove design notes
    - outputs/shuttercontrol_bom.csv/.xlsx: add TE 534237-6 (LCSC C5511697,
    DigiKey A26420-ND) as a qty-0 alternate for J1 on the same footprint
    - docs/questions.md: remove design question log (renamed to notes.md, then
    deleted)
    - docs/shuttercontrol_schematic.pdf: remove outdated schematic PDF copy
    [shuttercontrol_bom.csv, shuttercontrol_bom.xlsx]
2026-11-11 docs: add schematic pinout verification against datasheets
    - docs/pinout_verification.md: record pin-by-pin checks of all ICs,
    regulators, diodes, trimmers, switches and polarized capacitors against
    manufacturer datasheets, the PCB pad/net cross-check, open items and sources
